Trugath/XTMax/hardware/fabrication/XTMAX_BOM.xlsx

Comment | Designator | Footprint | JLCPCB Part #（optional）
8 24mA 1.65V~3.6V 24mA 1 TSSOP-20 Buffer/Driver/Transceiver ROHS | U1, U3, U4, U7, U8 | TSSOP-20 | C7848
4 24mA 1.65V~3.6V 24mA 2 TSSOP-20 Buffers, Drivers, Receivers, Transceivers ROHS | U5 | TSSOP-20 | C7668
6.3V 10uF X5R ±20% 0402 Multilayer Ceramic Capacitors MLCC - SMD/SMT ROHS | C1, C2, C3, C4 | 402 | C15525
