Trugath/XTMax/hardware/pcb/XTMAX_PCB.kicad_pcb

## KiCad design hardware/pcb/XTMAX_PCB.kicad_pcb (2026-04-01)

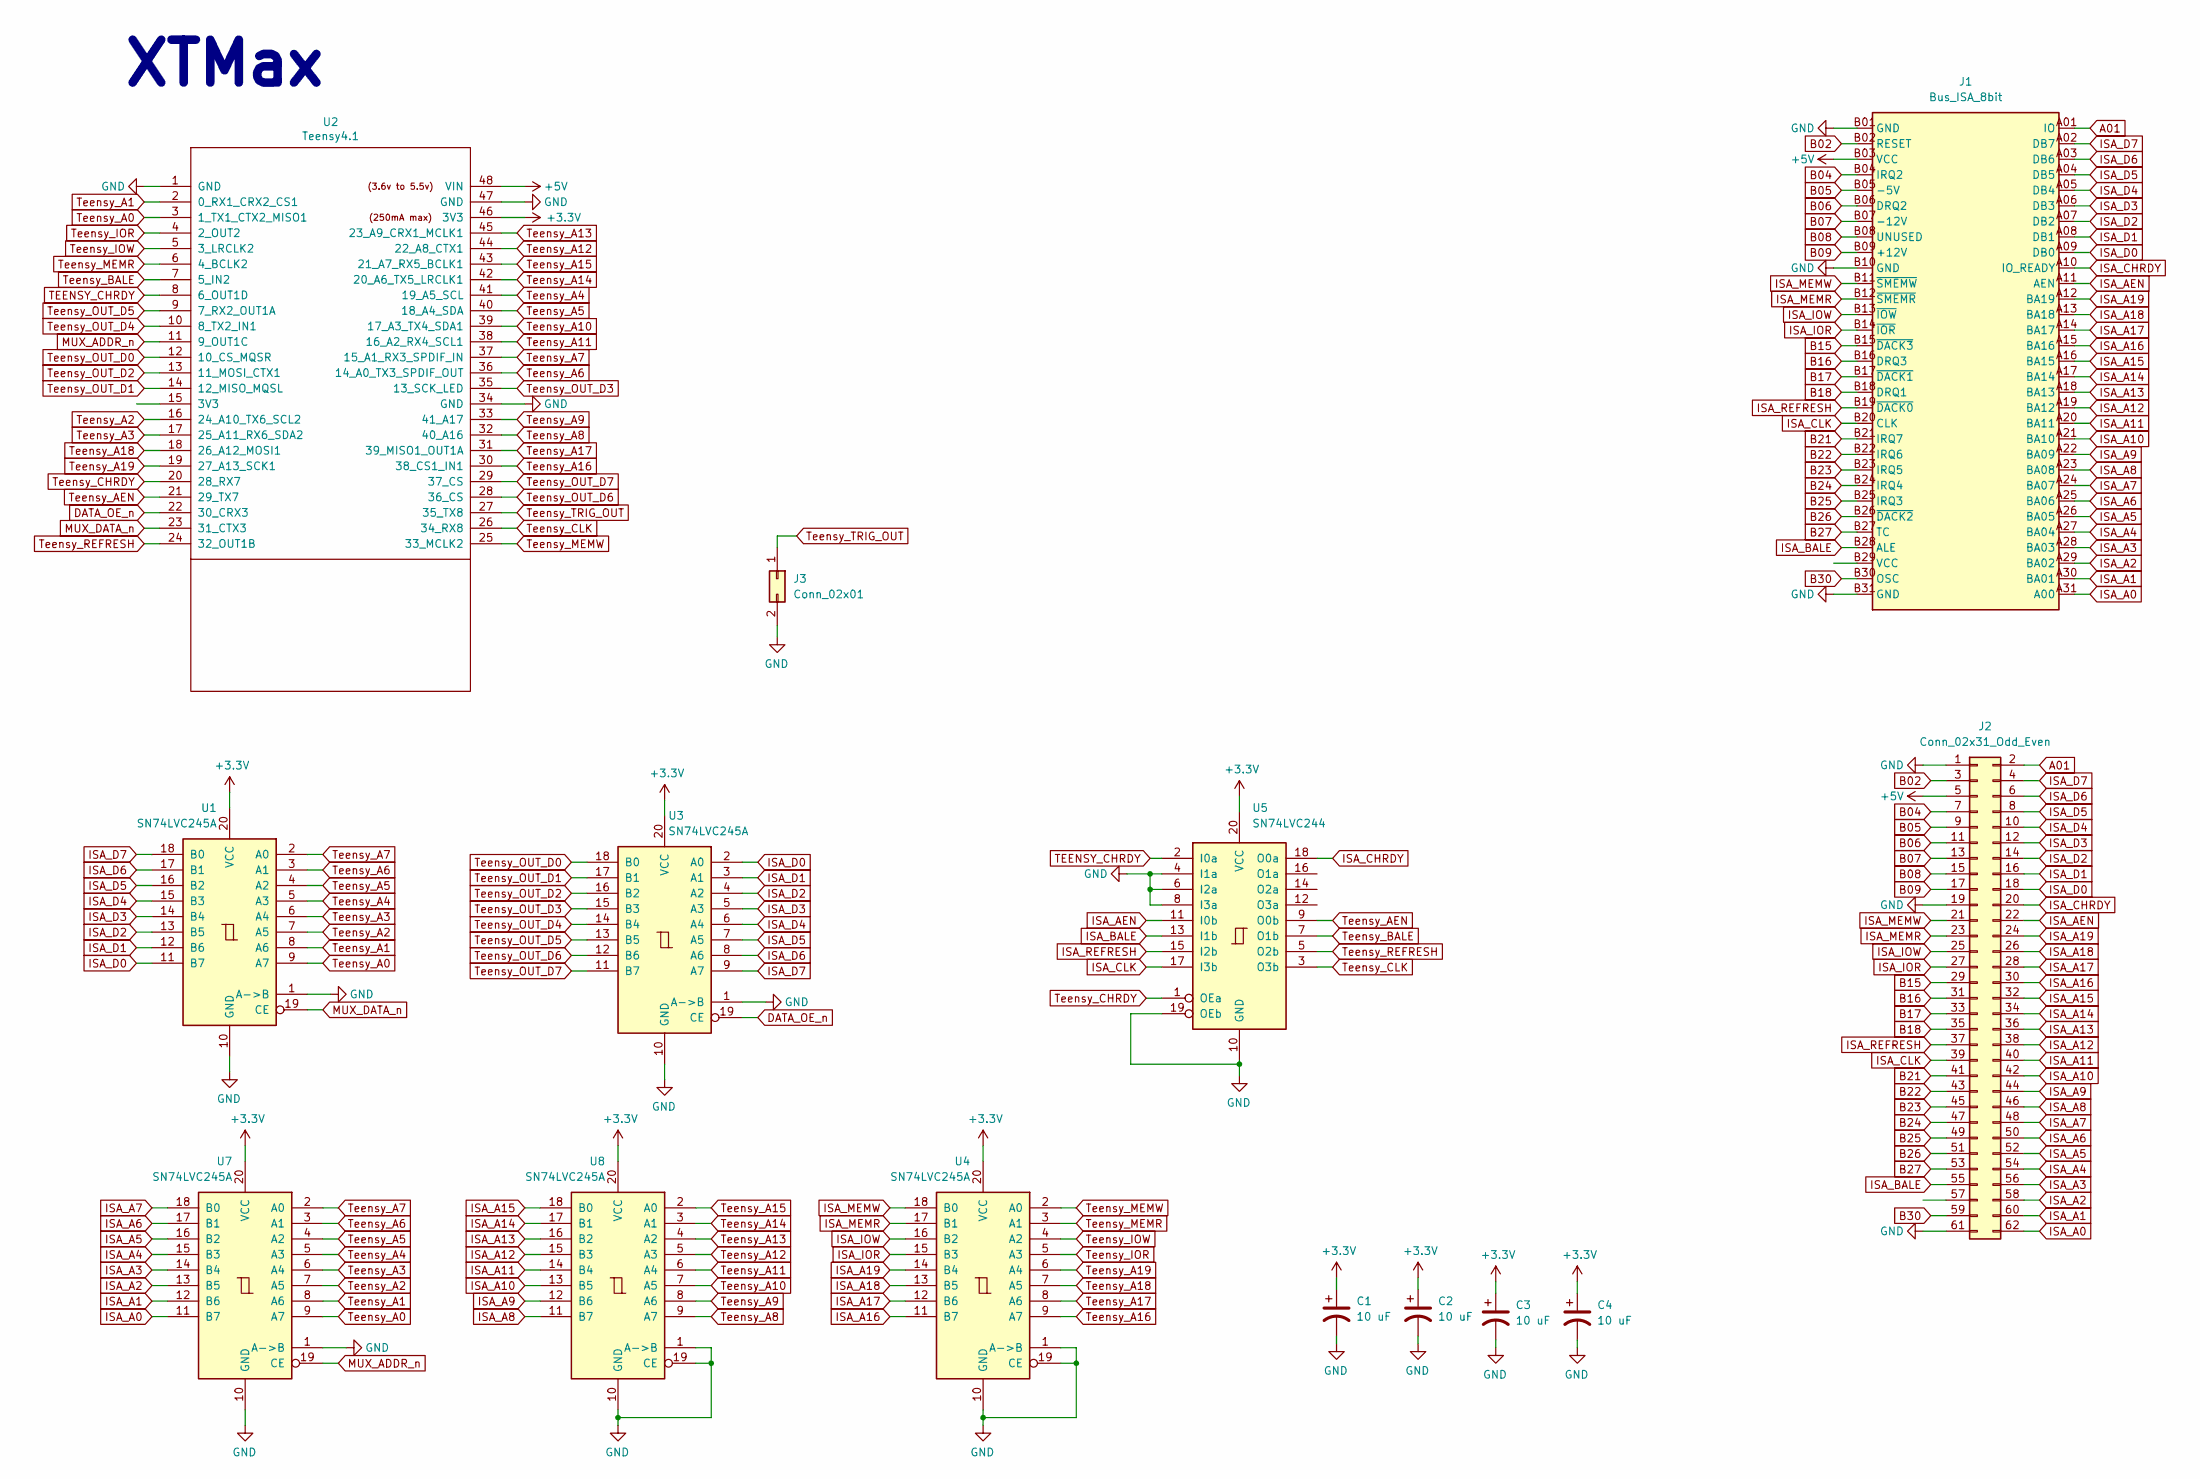
[picture p1: schematic XTMAX_PCB.kicad_sch]

Parts:
C1, C2, C3, C4: 10 uF; C_0402_1005Metric
J1: Bus_ISA_8bit; isa
J2: Conn_02x31_Odd_Even; PinHeader_2x31_P2.54mm_Vertical
J3: Conn_02x01; PinHeader_2x01_P2.54mm_Vertical
U1, U3, U4, U7, U8: SN74LVC245A; TSSOP-20_4.4x6.5mm_P0.65mm
U2: Teensy4.1; Teensy41_Ted_Modified
U5: SN74LVC244; TSSOP-20_4.4x6.5mm_P0.65mm

Connections:
+3V3: C1.1, C2.1, C3.1, C4.1, U1.20 (VCC), U2.46 (3V3), U3.20 (VCC), U4.20 (VCC), U5.20 (VCC), U7.20 (VCC), U8.20 (VCC)
+5V: J1.B03 (VCC), J2.5, U2.48 (VIN)
A01: J1.A01 (IO), J2.2
B02: J1.B02 (RESET), J2.3
B04: J1.B04 (IRQ2), J2.7
B05: J1.B05 (-5V), J2.9
B06: J1.B06 (DRQ2), J2.11
B07: J1.B07 (-12V), J2.13
B08: J1.B08 (UNUSED), J2.15
B09: J1.B09 (+12V), J2.17
B15: J1.B15 (~DACK3), J2.29
B16: J1.B16 (DRQ3), J2.31
B17: J1.B17 (~DACK1), J2.33
B18: J1.B18 (DRQ1), J2.35
B21: J1.B21 (IRQ7), J2.41
B22: J1.B22 (IRQ6), J2.43
B23: J1.B23 (IRQ5), J2.45
B24: J1.B24 (IRQ4), J2.47
B25: J1.B25 (IRQ3), J2.49
B26: J1.B26 (~DACK2), J2.51
B27: J1.B27 (TC), J2.53
B30: J1.B30 (OSC), J2.59
DATA_OE_n: U2.22 (30_CRX3), U3.19 (CE)
GND: C1.2, C2.2, C3.2, C4.2, J1.B01 (GND), J1.B10 (GND), J1.B31 (GND), J2.1, J2.19, J2.61, J3.2, U1.1 (A->B), U1.10 (GND), U2.1 (GND), U2.34 (GND), U2.47 (GND), U3.1 (A->B), U3.10 (GND), U4.1 (A->B), U4.10 (GND), U4.19 (CE), U5.4 (I1a), U5.6 (I2a), U5.8 (I3a), U5.10 (GND), U5.19 (OEb), U7.1 (A->B), U7.10 (GND), U8.1 (A->B), U8.10 (GND), U8.19 (CE)
ISA_A0: J1.A31 (A00), J2.62, U7.11 (B7)
ISA_A1: J1.A30 (BA01), J2.60, U7.12 (B6)
ISA_A2: J1.A29 (BA02), J2.58, U7.13 (B5)
ISA_A3: J1.A28 (BA03), J2.56, U7.14 (B4)
ISA_A4: J1.A27 (BA04), J2.54, U7.15 (B3)
ISA_A5: J1.A26 (BA05), J2.52, U7.16 (B2)
ISA_A6: J1.A25 (BA06), J2.50, U7.17 (B1)
ISA_A7: J1.A24 (BA07), J2.48, U7.18 (B0)
ISA_A8: J1.A23 (BA08), J2.46, U8.11 (B7)
ISA_A9: J1.A22 (BA09), J2.44, U8.12 (B6)
ISA_A10: J1.A21 (BA10), J2.42, U8.13 (B5)
ISA_A11: J1.A20 (BA11), J2.40, U8.14 (B4)
ISA_A12: J1.A19 (BA12), J2.38, U8.15 (B3)
ISA_A13: J1.A18 (BA13), J2.36, U8.16 (B2)
ISA_A14: J1.A17 (BA14), J2.34, U8.17 (B1)
ISA_A15: J1.A16 (BA15), J2.32, U8.18 (B0)
ISA_A16: J1.A15 (BA16), J2.30, U4.11 (B7)
ISA_A17: J1.A14 (BA17), J2.28, U4.12 (B6)
ISA_A18: J1.A13 (BA18), J2.26, U4.13 (B5)
ISA_A19: J1.A12 (BA19), J2.24, U4.14 (B4)
ISA_AEN: J1.A11 (AEN), J2.22, U5.11 (I0b)
ISA_BALE: J1.B28 (ALE), J2.55, U5.13 (I1b)
ISA_CHRDY: J1.A10 (IO_READY), J2.20, U5.18 (O0a)
ISA_CLK: J1.B20 (CLK), J2.39, U5.17 (I3b)
ISA_D0: J1.A09 (DB0), J2.18, U1.11 (B7), U3.2 (A0)
ISA_D1: J1.A08 (DB1), J2.16, U1.12 (B6), U3.3 (A1)
ISA_D2: J1.A07 (DB2), J2.14, U1.13 (B5), U3.4 (A2)
ISA_D3: J1.A06 (DB3), J2.12, U1.14 (B4), U3.5 (A3)
ISA_D4: J1.A05 (DB4), J2.10, U1.15 (B3), U3.6 (A4)
ISA_D5: J1.A04 (DB5), J2.8, U1.16 (B2), U3.7 (A5)
ISA_D6: J1.A03 (DB6), J2.6, U1.17 (B1), U3.8 (A6)
ISA_D7: J1.A02 (DB7), J2.4, U1.18 (B0), U3.9 (A7)
ISA_IOR: J1.B14 (~IOR), J2.27, U4.15 (B3)
ISA_IOW: J1.B13 (~IOW), J2.25, U4.16 (B2)
ISA_MEMR: J1.B12 (~SMEMR), J2.23, U4.17 (B1)
ISA_MEMW: J1.B11 (~SMEMW), J2.21, U4.18 (B0)
ISA_REFRESH: J1.B19 (~DACK0), J2.37, U5.15 (I2b)
MUX_ADDR_n: U2.11 (9_OUT1C), U7.19 (CE)
MUX_DATA_n: U1.19 (CE), U2.23 (31_CTX3)
TEENSY_CHRDY: U2.8 (6_OUT1D), U5.2 (I0a)
Teensy_A0: U1.9 (A7), U2.3 (1_TX1_CTX2_MISO1), U7.9 (A7)
Teensy_A1: U1.8 (A6), U2.2 (0_RX1_CRX2_CS1), U7.8 (A6)
Teensy_A2: U1.7 (A5), U2.16 (24_A10_TX6_SCL2), U7.7 (A5)
Teensy_A3: U1.6 (A4), U2.17 (25_A11_RX6_SDA2), U7.6 (A4)
Teensy_A4: U1.5 (A3), U2.41 (19_A5_SCL), U7.5 (A3)
Teensy_A5: U1.4 (A2), U2.40 (18_A4_SDA), U7.4 (A2)
Teensy_A6: U1.3 (A1), U2.36 (14_A0_TX3_SPDIF_OUT), U7.3 (A1)
Teensy_A7: U1.2 (A0), U2.37 (15_A1_RX3_SPDIF_IN), U7.2 (A0)
Teensy_A8: U2.32 (40_A16), U8.9 (A7)
Teensy_A9: U2.33 (41_A17), U8.8 (A6)
Teensy_A10: U2.39 (17_A3_TX4_SDA1), U8.7 (A5)
Teensy_A11: U2.38 (16_A2_RX4_SCL1), U8.6 (A4)
Teensy_A12: U2.44 (22_A8_CTX1), U8.5 (A3)
Teensy_A13: U2.45 (23_A9_CRX1_MCLK1), U8.4 (A2)
Teensy_A14: U2.42 (20_A6_TX5_LRCLK1), U8.3 (A1)
Teensy_A15: U2.43 (21_A7_RX5_BCLK1), U8.2 (A0)
Teensy_A16: U2.30 (38_CS1_IN1), U4.9 (A7)
Teensy_A17: U2.31 (39_MISO1_OUT1A), U4.8 (A6)
Teensy_A18: U2.18 (26_A12_MOSI1), U4.7 (A5)
Teensy_A19: U2.19 (27_A13_SCK1), U4.6 (A4)
Teensy_AEN: U2.21 (29_TX7), U5.9 (O0b)
Teensy_BALE: U2.7 (5_IN2), U5.7 (O1b)
Teensy_CHRDY: U2.20 (28_RX7), U5.1 (OEa)
Teensy_CLK: U2.26 (34_RX8), U5.3 (O3b)
Teensy_IOR: U2.4 (2_OUT2), U4.5 (A3)
Teensy_IOW: U2.5 (3_LRCLK2), U4.4 (A2)
Teensy_MEMR: U2.6 (4_BCLK2), U4.3 (A1)
Teensy_MEMW: U2.25 (33_MCLK2), U4.2 (A0)
Teensy_OUT_D0: U2.12 (10_CS_MQSR), U3.18 (B0)
Teensy_OUT_D1: U2.14 (12_MISO_MQSL), U3.17 (B1)
Teensy_OUT_D2: U2.13 (11_MOSI_CTX1), U3.16 (B2)
Teensy_OUT_D3: U2.35 (13_SCK_LED), U3.15 (B3)
Teensy_OUT_D4: U2.10 (8_TX2_IN1), U3.14 (B4)
Teensy_OUT_D5: U2.9 (7_RX2_OUT1A), U3.13 (B5)
Teensy_OUT_D6: U2.28 (36_CS), U3.12 (B6)
Teensy_OUT_D7: U2.29 (37_CS), U3.11 (B7)
Teensy_REFRESH: U2.24 (32_OUT1B), U5.5 (O2b)
Teensy_TRIG_OUT: J3.1, U2.27 (35_TX8)

Notes on the sheet:
XTMax

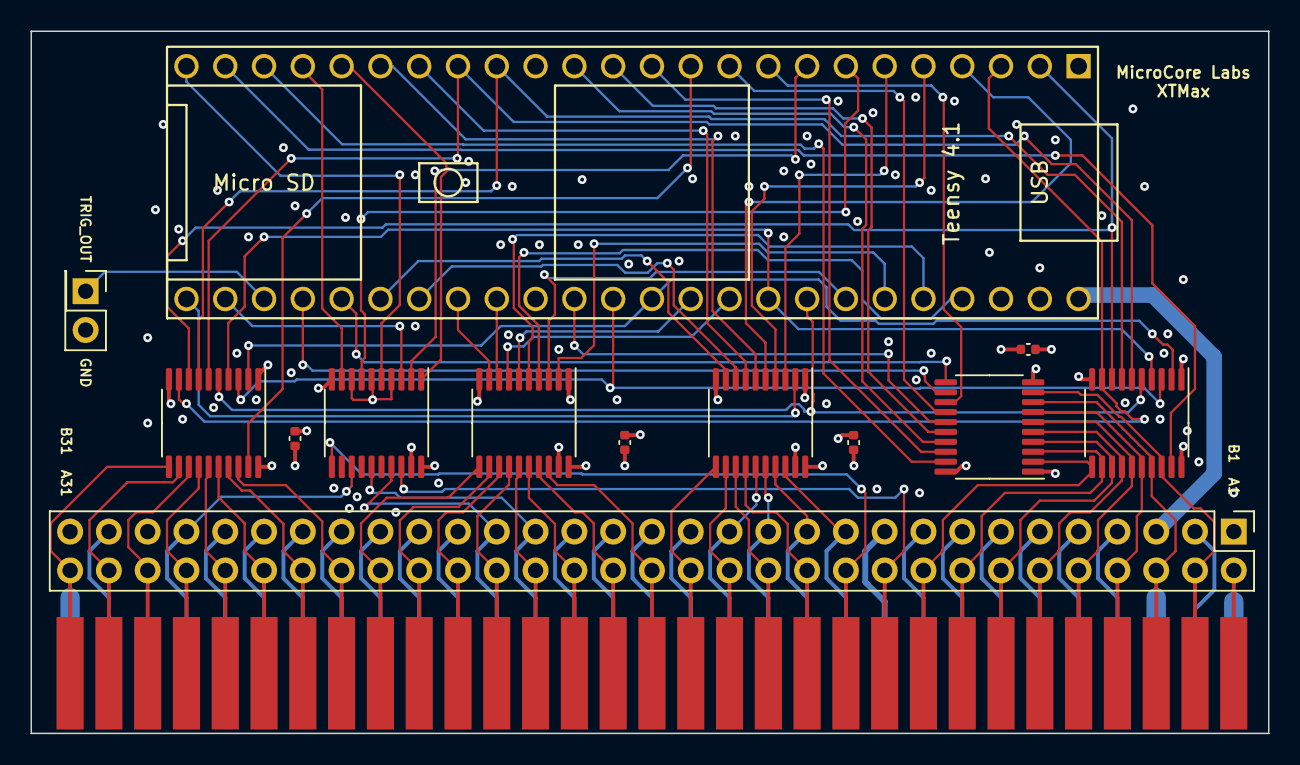
[picture p2: board XTMAX_PCB.kicad_pcb from above]

Board: 4 copper layers, 81.0 x 46.0 mm, 14 parts (0 on the bottom side), 102 nets.
