Trugath/XTMax/firmware/teensy/bootrom.h

#define BOOTROM_ADDR 0xce000
unsigned char BOOTROM[] = {
    85, 170, 4, 6, 80, 81, 82, 250, 184, 121, 7, 232, 186, 6, 232, 197,
    4, 114, 115, 49, 192, 142, 192, 38, 161, 78, 0, 186, 131, 2, 239, 38,
    161, 76, 0, 186, 133, 2, 239, 140, 200, 38, 163, 78, 0, 184, 140, 0,
    38, 163, 76, 0, 184, 64, 0, 142, 192, 38, 160, 117, 0, 4, 128, 186,
    130, 2, 238, 80, 38, 254, 6, 117, 0, 88, 49, 201, 142, 193, 60, 128,
    117, 15, 140, 200, 38, 163, 6, 1, 184, 90, 1, 38, 163, 4, 1, 235,
    13, 140, 200, 38, 163, 26, 1, 184, 90, 1, 38, 163, 24, 1, 140, 200,
    38, 163, 98, 0, 38, 163, 102, 0, 184, 88, 3, 38, 163, 96, 0, 184,
    53, 3, 38, 163, 100, 0, 251, 90, 89, 88, 7, 203, 251, 85, 86, 80,
    82, 186, 130, 2, 236, 90, 56, 194, 88, 116, 58, 137, 197, 137, 214, 156,
    14, 184, 181, 0, 80, 186, 131, 2, 237, 80, 186, 133, 2, 237, 80, 137,
    232, 137, 242, 250, 203, 251, 156, 80, 137, 240, 60, 128, 114, 19, 137, 232,
    128, 252, 8, 117, 12, 6, 184, 64, 0, 142, 192, 38, 138, 22, 117, 0,
    7, 88, 157, 235, 58, 128, 252, 25, 126, 5, 232, 122, 0, 235, 34, 128,
    252, 1, 116, 10, 128, 252, 21, 116, 5, 190, 1, 1, 235, 3, 190, 15,
    1, 86, 137, 222, 136, 227, 48, 255, 208, 227, 135, 243, 46, 255, 164, 35,
    1, 140, 197, 190, 64, 0, 142, 198, 38, 136, 38, 116, 0, 142, 197, 137,
    229, 139, 118, 8, 86, 115, 4, 157, 249, 235, 2, 157, 248, 94, 93, 251,
    202, 2, 0, 26, 3, 106, 1, 126, 1, 20, 2, 219, 2, 87, 1, 87,
    1, 87, 1, 246, 2, 26, 3, 87, 1, 87, 1, 12, 3, 26, 3, 87,
    1, 87, 1, 26, 3, 26, 3, 87, 1, 87, 1, 26, 3, 28, 3, 87,
    1, 87, 1, 87, 1, 26, 3, 233, 207, 1, 255, 3, 16, 0, 0, 255,
    255, 0, 200, 0, 0, 0, 0, 0, 63, 0, 6, 189, 64, 0, 142, 197,
    48, 228, 38, 134, 38, 116, 0, 132, 228, 116, 1, 249, 7, 195, 132, 192,
    117, 3, 233, 164, 1, 80, 48, 228, 137, 198, 83, 232, 206, 2, 137, 197,
    1, 240, 137, 222, 131, 211, 0, 232, 12, 3, 91, 88, 115, 3, 233, 140,
    1, 30, 83, 81, 82, 87, 80, 137, 193, 48, 237, 140, 200, 142, 216, 137,
    223, 186, 129, 2, 176, 0, 238, 81, 137, 232, 137, 243, 232, 240, 4, 177,
    81, 232, 195, 4, 114, 60, 186, 135, 2, 176, 10, 238, 186, 128, 2, 236,
    60, 254, 116, 10, 186, 135, 2, 236, 132, 192, 117, 38, 235, 238, 185, 0,
    1, 86, 190, 0, 8, 252, 243, 165, 173, 94, 131, 197, 1, 131, 214, 0,
    89, 226, 196, 186, 129, 2, 176, 1, 238, 88, 95, 90, 89, 91, 31, 233,
    47, 1, 186, 129, 2, 176, 1, 238, 89, 88, 40, 200, 95, 90, 89, 91,
    31, 233, 17, 1, 132, 192, 117, 3, 233, 14, 1, 80, 48, 228, 137, 198,
    83, 232, 56, 2, 137, 197, 1, 240, 137, 222, 131, 211, 0, 232, 118, 2,
    91, 88, 115, 3, 233, 246, 0, 30, 83, 81, 82, 87, 80, 137, 193, 48,
    237, 137, 223, 140, 192, 142, 216, 140, 200, 142, 192, 186, 129, 2, 176, 0,
    238, 81, 137, 232, 137, 243, 232, 86, 4, 177, 88, 232, 41, 4, 114, 102,
    186, 128, 2, 176, 254, 238, 185, 0, 1, 86, 137, 254, 191, 0, 8, 252,
    243, 165, 137, 247, 94, 186, 135, 2, 176, 25, 238, 186, 128, 2, 236, 60,
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
