Trugath/XTMax/(commit log)

2026-04-01 Reorganize repo layout
    [TLINK.CFG, TURBOC.CFG, XTMAX_BOM.xlsx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]
2026-04-01 Refactor Teensy shared core
2026-04-02 Add ibm5160 MAME driver flow
2026-04-03 Add MAME ROM capture via Teensy USB
    Made-with: Cursor
